shannon-greenlight/Spankulator-Hardware/README.md

# Spankulator-Hardware
The schematics, netlists, etc.
Uses KiCAD
Needs Spankulator-Panel
This version adds separate control of external trigger enable.
Now uses full-width main board.
