shannon-greenlight/Spankulator-Hardware/Spankulator.xlsx

Reference | Quantity | Value | Digi-Key Part | URL
A1 | 1 | Arduino_Nano_33IoT | 1050-ABX00032-ND | https://www.amazon.com/Arduino-Nano-33-IoT/dp/B07VW9TSKD/
C1 C2 | 2 | 10nF | BC2662CT-ND
C14 | 1 | 1uF | 445-180204-ND
C3 C4 | 2 | 100uF | 1189-3982-ND
C5 C6 C7 C9 C12 C13 | 6 | 100nF | 399-4329-ND
C8 C10 | 2 | 330nF | 445-173597-1-ND
D1 D2 D8 D7 D9 D10 D12 D11 D18 D17 D16 D15 D20 D19 | 14 | SB120 | SB120FSCT-ND
D14 | 1 | RED LED | 732-5005-ND
D3 | 1 | GREEN LED | 732-5008-ND
D4 | 1 | BLUE LED | 732-11401-ND
D5 | 1 | YELLOW LED | 160-1961-ND
D6 D13 | 2 | 1N4148 | 1N4148VSCT-ND
H2 H3 H1 H4 | 4 | MountingHole
H5 H6 H7 | 3 | MountingHole
J10 | 1 | FRAM Pins | 732-5321-ND
J11 | 1 | OLED Pins | 732-5317-ND
J12 J13 | 2 | Arduino Socket | S7048-ND
J14 | 1 | Eurorack Power Cable | H3CCS-1618G-ND
J3 J4 J5 J6 J1 | 5 | 3.5mm Jack | WM17366-ND
J7 | 1 | Expansion Header | S2011EC-04-ND
J8 | 1 | FRAM Header | S7041-ND
J9 | 1 | Display Header | S7037-ND
KN1 | 1 | Selector Knob | 226-4215-ND
KN2 | 1 | Scale Knob | 1722-1241-ND
M1 | 1 | FRAM_Module | 1528-1035-ND
M2 | 1 | OLED_Module |  | https://www.amazon.com/gp/product/B072Q2X2LL/
N1 N2 N3 N4 N5 N6 N7 | 7 | Nut | 36-4687-ND
Q1 Q6 | 2 | TN2106 | TN2106N3-G-ND
Q4 Q2 | 2 | 2N3906 | 2N3906FS-ND
Q5 Q3 | 2 | 2N3904 | 2N3904-APCT-ND
R1 R15 R11 R5 R8 R21 | 6 | 10K | CF14JT10K0CT-ND
R13 R6 R26 R27 R12 | 5 | 100K | RNF14FTD100KCT-ND
R16 R10 | 2 | 47K | CF14JT47K0CT-ND
R17 R23 R24 R28 | 4 | 301K | 301KXBK-ND
R19 R18 R7 R9 R20 R25 | 6 | 470 | PPC470W-1CT-ND
R2 R4 R3 R14 | 4 | 1K | CF14JT1K00CT-ND
R30 | 1 | 133K | 133KXBK-ND
R31 R29 | 2 | 200K | 200KXBK-ND
RV1 | 1 | 1K | PTV09A-4225F-B102-ND
SC1 SC2 SC3 SC4 SC5 | 5 | Nylon Screw | 36-29331-ND
SC6 SC7 SC8 SC9 | 4 | Mounting Screw | 335-1156-ND
SK3 | 1 | A_14-LC-TT | AE9989-ND
SK4 SK5 | 2 | A_08-LC-TT | AE9986-ND
SO1 SO2 SO3 SO4 | 4 | Standoff 12mm | 732-13063-ND
SO5 SO6 SO7 | 3 | Standoff 11mm | 732-13059-ND
SW1 | 1 | Adj | PEC12R-4230F-S0024-ND
SW5 SW4 SW3 SW2 SW7 SW6 SW8 | 7 | ~ | 450-1643-ND
TP1 TP2 | 2 | TestPoint | 36-5006-ND
U1 U3 | 2 | TL072 | 296-14997-5-ND
U2 | 1 | CD4013BE | 296-2033-5-ND
U4 | 1 | MC7805CTG | MC7805CTGOS-ND
W1 W2 W3 W4 | 4 | Washer | RPC3448-ND
