shannon-greenlight/Spankulator-Hardware/Spankulator.pdf

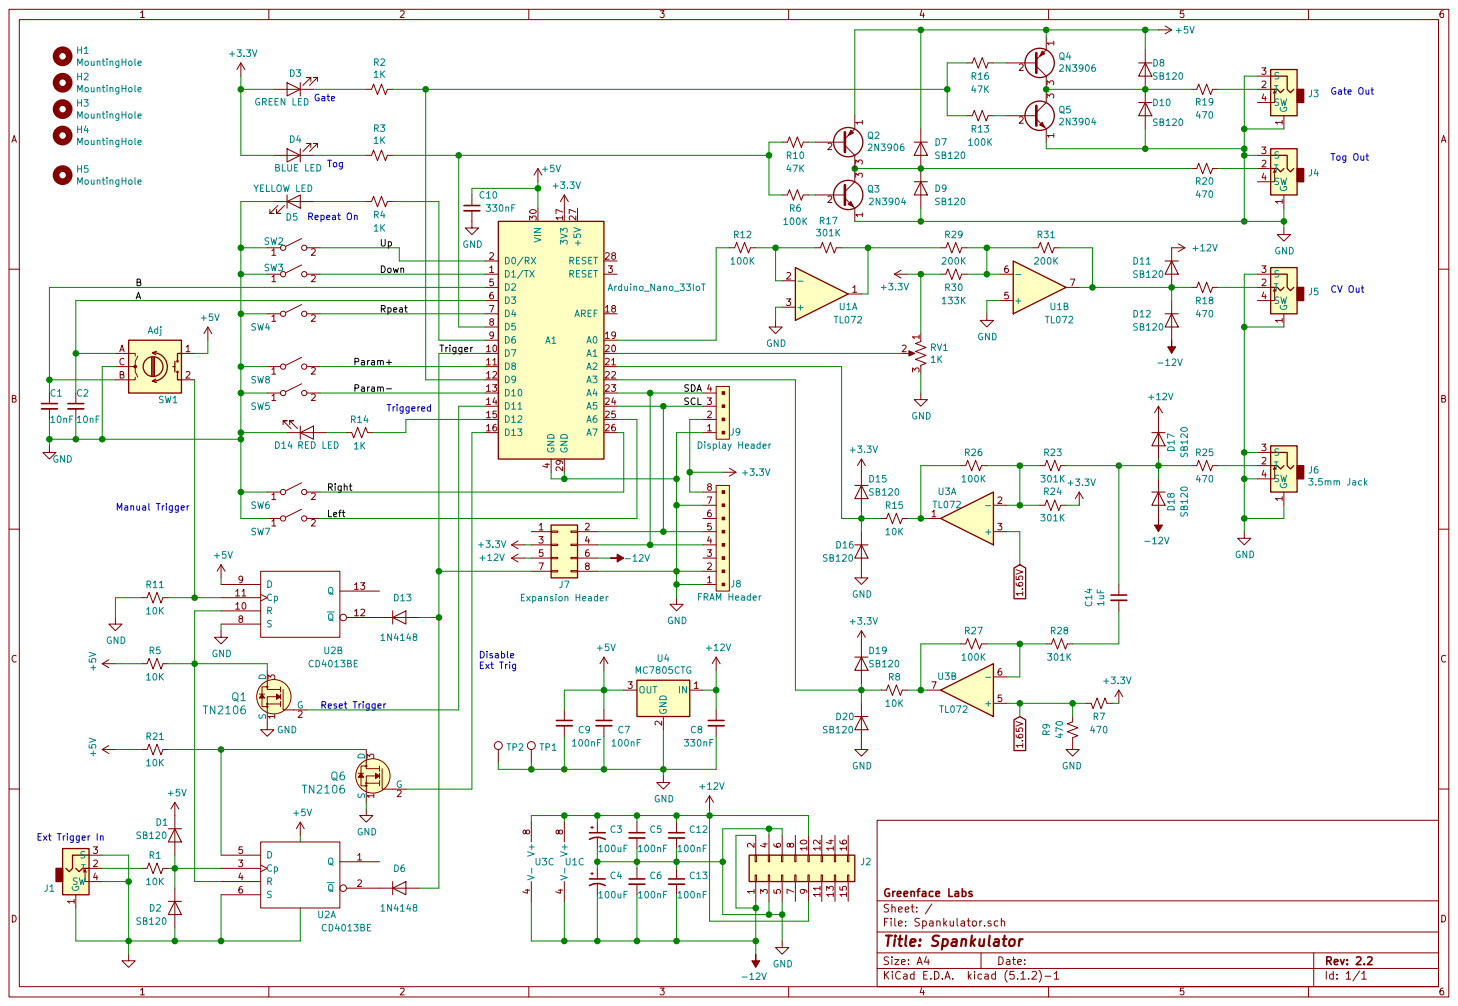
[picture p1: page 1]

301K GateTog
Up Down Rpeat Param+ Param- Right

File: Spankulator.sch Sheet: / Greenface Labs
