shannon-greenlight/Spankulator-Hardware/Spankulator.kicad_pcb

## KiCad design Spankulator.kicad_pcb (2021-05-21)

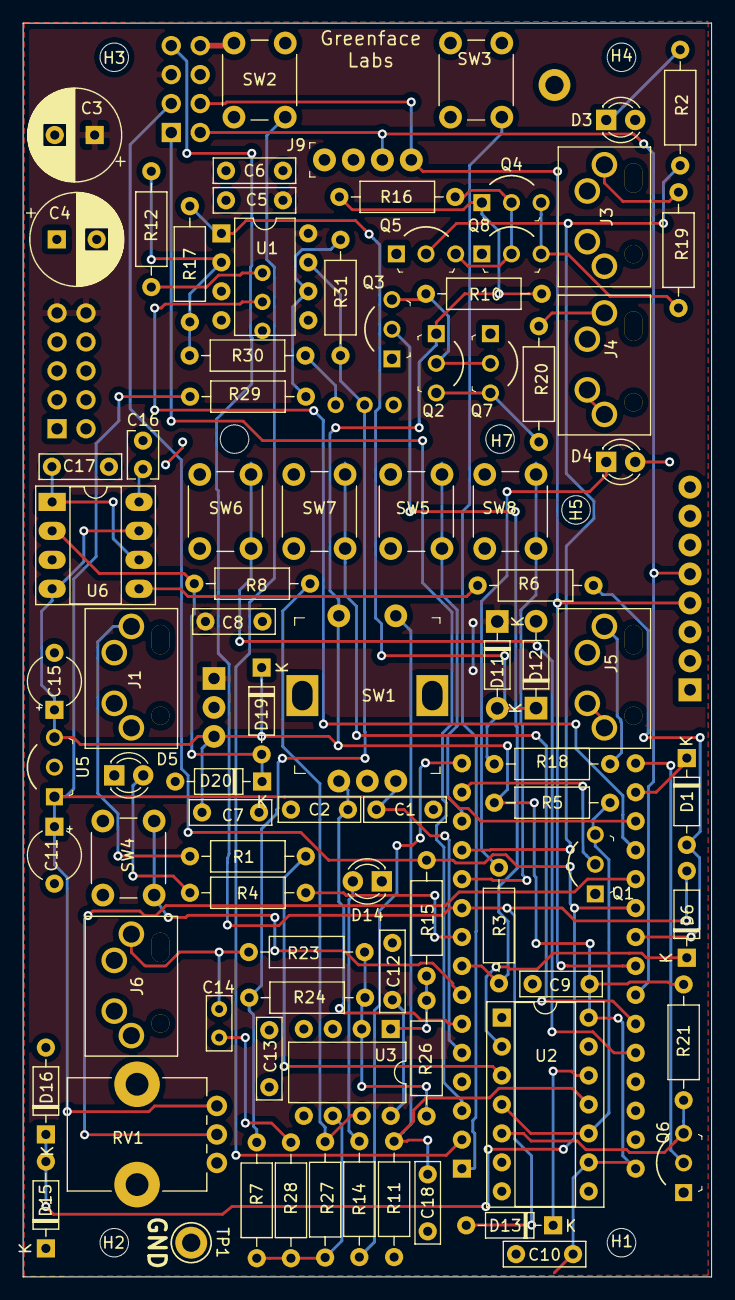
[picture p2: board Spankulator.kicad_pcb from above]

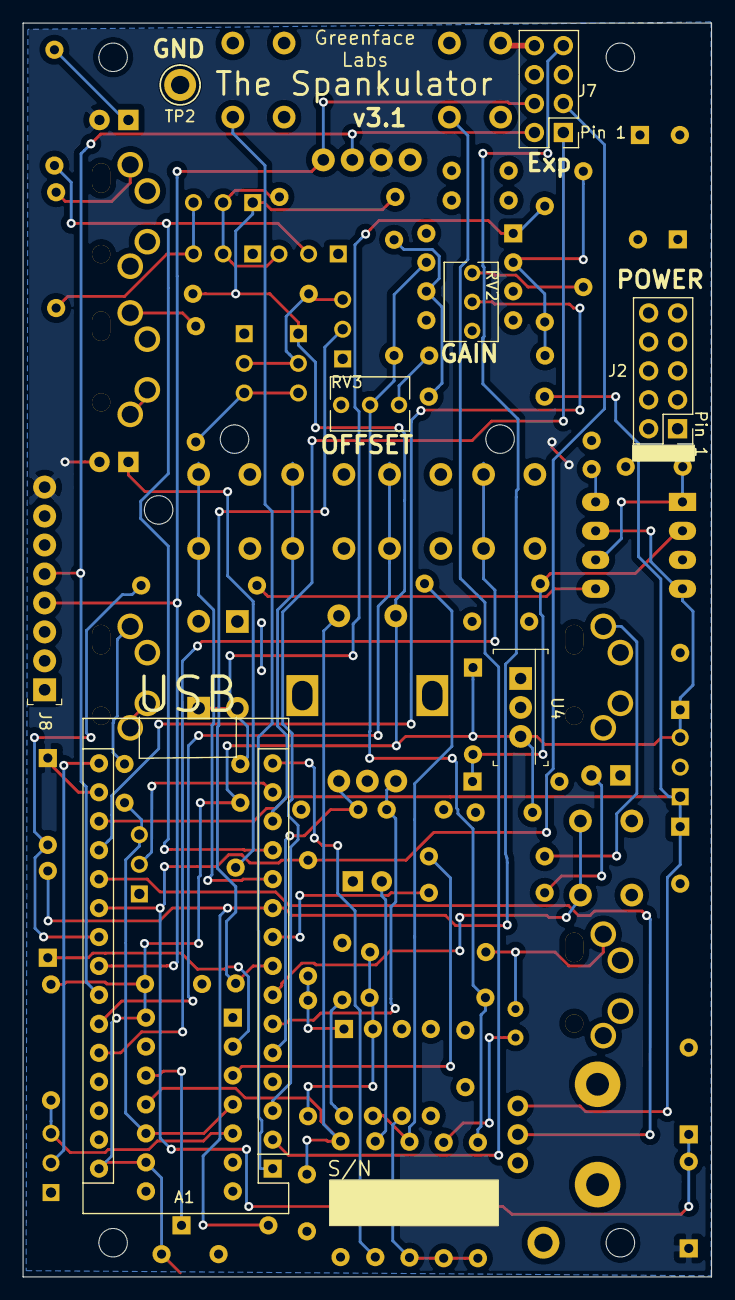
[picture p3: board Spankulator.kicad_pcb from below]

Board: 4 copper layers, 60.4 x 110.0 mm, 102 parts (8 on the bottom side), 63 nets.

Parts:
A1: Nano_33IoT; Arduino_Nano
C1, C2, C18: 10nF; C_Rect_L7.0mm_W2.0mm_P5.00mm
C3, C4: 100uF; CP_Radial_D8.0mm_P3.50mm
C5, C6, C7, C9, C12, C13, C17: 100nF; C_Rect_L7.0mm_W2.0mm_P5.00mm
C8, C10: 330nF; C_Rect_L7.0mm_W2.0mm_P5.00mm
C11, C15: 2.2uF; CP_Radial_Tantal_D4.5mm_P5.00mm_Min
C14: 1uF; C_Rect_L4.6mm_W2.0mm_P2.50mm_MKS02_FKP02
C16: 270p; C_Rect_L4.0mm_W2.5mm_P2.50mm
D1, D15, D16, D19, D20: BAT46; D_DO-35_SOD27_P7.62mm_Horizontal
D3: GREEN LED; LED_D3.0mm
D4: BLUE LED; LED_D3.0mm
D5: YELLOW LED; LED_D3.0mm
D6, D13: 1N4148; D_DO-35_SOD27_P7.62mm_Horizontal
D11, D12: SB120; D_DO-41_SOD27_P7.62mm_Horizontal
D14: RED LED; LED_D3.0mm
H1, H2, H3, H4: MountingHole; MountingHole_2.5mm
H5, H6, H7: MountingHole; MountingHole_2.5mm-No-Margin
J1, J3, J4, J5, J6: 3.5mm Jack; Molex-0472570001
J2: 2x5 Header; PinHeader_2x05_P2.54mm_Vertical
J7: Expansion Header; PinHeader_2x04_P2.54mm_Vertical
J8: FRAM Header; PinHeader_1x8_P2.54mm_Drill1.02mm
J9: Display Header; OLED_Header
Q1, Q3, Q5, Q6, Q7, Q8: TN2106; TO-92-3_Formed_Leads
Q2, Q4: VP2106; TO-92-3_Formed_Leads
R1, R5, R6, R8, R11, R15, R21: 10K; R_Axial_DIN0207_L6.3mm_D2.5mm_P10.16mm_Horizontal
R2, R3, R4, R14: 1K; R_Axial_DIN0207_L6.3mm_D2.5mm_P10.16mm_Horizontal
R7, R24, R26, R27, R31: 100K .1%; R_Axial_DIN0207_L6.3mm_D2.5mm_P10.16mm_Horizontal
R10, R16: 100K; R_Axial_DIN0207_L6.3mm_D2.5mm_P10.16mm_Horizontal
R12, R30: 95.3K 1%; R_Axial_DIN0207_L6.3mm_D2.5mm_P10.16mm_Horizontal
R17, R23, R28: 300K .1%; R_Axial_DIN0207_L6.3mm_D2.5mm_P10.16mm_Horizontal
R18, R19, R20: 470; R_Axial_DIN0207_L6.3mm_D2.5mm_P10.16mm_Horizontal
R29: 200K .1%; R_Axial_DIN0207_L6.3mm_D2.5mm_P10.16mm_Horizontal
RV1: 1K; Potentiometer_Bourns_PTV09A-1_Single_Vertical
RV2, RV3: 10K; Potentiometer_Bourns_3266Y_Vertical
SW1: Adj; Rotary_Encoder_Switched_PEC11R
SW2, SW3, SW4, SW5, SW6, SW7, SW8: Push Button; SW_PUSH_6mm
TP1, TP2: TestPoint; TestPoint_Keystone_5005-5009_Compact
U1, U3: TL072; DIP-8_W7.62mm
U2: CD4013BE; DIP-14_W7.62mm_Socket
U4: MC7805CTG; TO-220-3
U5: LP2950-3.3_TO92; TO-92-3_Formed_Leads
U6: MAX7480; DIP-8_W7.62mm_Socket_LongPads

Connections:
3.3VRef: A1.18, C11.1, R29.2, RV1.1, U5.1
+3V3: A1.17, D1.1, D3.2, D4.2, D15.1, J8.8, J9.2
+5V: A1.30, C7.1, C9.1, C10.1, C15.1, D19.1, Q2.1, Q4.1, R5.2, R10.1, R16.1, R21.2, SW1.1, U2.9, U2.14, U4.3, U5.3, U6.4, U6.7
+12V: C3.1, C5.1, C8.1, C12.1, D11.1, J2.9, J2.10, J7.5, U1.8, U3.8, U4.1
-1.65V: R7.2, R24.2, R31.1, RV3.2, U1.7
-12V: C4.2, C6.2, C13.2, D12.2, J2.1, J2.2, J7.6, U1.4, U3.4
/A: A1.6, C2.1, SW1.A
/B: A1.5, C1.1, SW1.B
/Down(v): A1.25, SW7.2
/FXN+: A1.2, SW2.2
/FXN-: A1.1, SW3.2
/Left(<): A1.13, SW5.2
/Right(>): A1.11, SW8.2
/Rpeat: A1.7, SW4.2
/SCL: A1.24, J7.2, J8.5, J9.3
/SDA: A1.23, J7.4, J8.4, J9.4
/Trigger: A1.10, D6.2, D13.2, J7.7
/Up(^): A1.26, SW6.2
GND: A1.4, A1.29, C1.2, C2.2, C3.2, C4.1, C5.2, C6.1, C7.2, C8.2, C9.2, C10.2, C11.2, C12.2, C13.1, C15.2, C16.2, C17.2, C18.2, D5.1, D14.1, D16.2, D20.2, J1.1, J1.3, J1.4, J2.3, J2.4, J2.5, J2.6, J3.1, J3.3, J4.1, J4.3, J5.1, J5.3, J6.1, J6.3, J6.4, J7.8, J8.1, J8.2, J8.7, J9.1, Q1.1, Q3.1, Q5.1, Q6.1, Q7.1, Q8.1, R11.2, RV1.3, SW1.C, SW2.1, SW3.1, SW4.1, SW5.1, SW6.1, SW7.1, SW8.1, TP1.1, TP2.1, U1.3, U1.5, U2.6, U2.7, U2.8, U3.3, U3.5, U4.2, U5.2, U6.3
unnamed: A1.8, Q3.2, R3.1
unnamed: A1.9, R4.1
unnamed: A1.12, Q5.2, R2.1
unnamed: A1.14, Q1.2
unnamed: A1.15, R14.2
unnamed: A1.16, Q6.2
unnamed: A1.19, RV2.2
unnamed: A1.20, RV1.2
unnamed: A1.22, D1.2, R6.2
unnamed: C14.1, J6.2, R23.1
unnamed: C14.2, R28.1
unnamed: C16.1, U6.8
unnamed: C17.1, U6.1, U6.6
unnamed: C18.1, R11.1, SW1.2, U2.11
unnamed: D3.1, R2.2
unnamed: D4.1, R3.2
unnamed: D5.2, R4.2
unnamed: D6.1, U2.2
unnamed: D11.2, D12.1, R17.1, R18.2, U1.1
unnamed: D13.1, U2.12
unnamed: D14.2, R14.1
unnamed: D19.2, D20.1, R8.2, U6.2
unnamed: J1.2, R1.2
unnamed: J3.2, R19.2
unnamed: J4.2, R20.2
unnamed: J5.2, R18.1
unnamed: Q1.3, R5.1, U2.4, U2.10
unnamed: Q2.2, Q3.3, Q7.2, R10.2
unnamed: Q2.3, Q7.3, R20.1
unnamed: Q4.2, Q5.3, Q8.2, R16.2
unnamed: Q4.3, Q8.3, R19.1
unnamed: Q6.3, R21.1, U2.5
unnamed: R1.1, U2.3
unnamed: R6.1, U6.5
unnamed: R12.1, R17.2, R30.1, U1.2
unnamed: R12.2, RV2.3
unnamed: R15.1, R26.2, U3.1
unnamed: R23.2, R24.1, R26.1, U3.2
unnamed: R7.1, R27.1, R28.2, U3.6
unnamed: R8.1, R27.2, U3.7
unnamed: R29.1, R31.2, U1.6
unnamed: R30.2, RV3.3
Reset: A1.3, J7.1
SigIn: A1.21, D15.2, D16.1, J7.3, R15.2
