shannon-greenlight/Spankulator-Hardware/(commit log)

2020-08-17 Added more files
    [Spankulator.csv, Spankulator.xlsx]
2020-08-17 Adds display to assembly instructions.
2020-08-17 Adds PDF of schematic
2020-08-17 Adds missing parts to BOM
    [Spankulator.xlsx]
2020-11-22 This version adds separate control of external trigger enable. Now uses full-width main board.
    [Spankulator.kicad_pcb]
2020-11-22 Removes gerber.zip
2021-01-24 Ver 2.3
    [Spankulator.kicad_pcb, Spankulator.sch, Spankulator.xlsx]
2021-02-03 Adds needed parts.
    [SpankParts.sch, Spankulator.sch, Spankulator.xlsx]
2021-02-09 Added Eurorack mounting screws
    [SpankParts.sch, Spankulator.xlsx]
2021-03-04 ver 3.0
    [SpankParts.sch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]
2021-05-21 Version 3.1
    Adds adjustment pots.
    [SpankParts.sch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]
